FridayUser/inz/README.md

View this project on [CADLAB.io](https://cadlab.io/project/28596). 

# inz
