FridayUser/inz/nowa wersja/Profiler energetyczny urządzeń IoT_V2/Profiler energetyczny urządzeń IoT.kicad_pcb

## KiCad design nowa wersja/Profiler energetyczny urządzeń IoT_V2/Profiler energetyczny urządzeń IoT.kicad_pcb (2024-10-24)

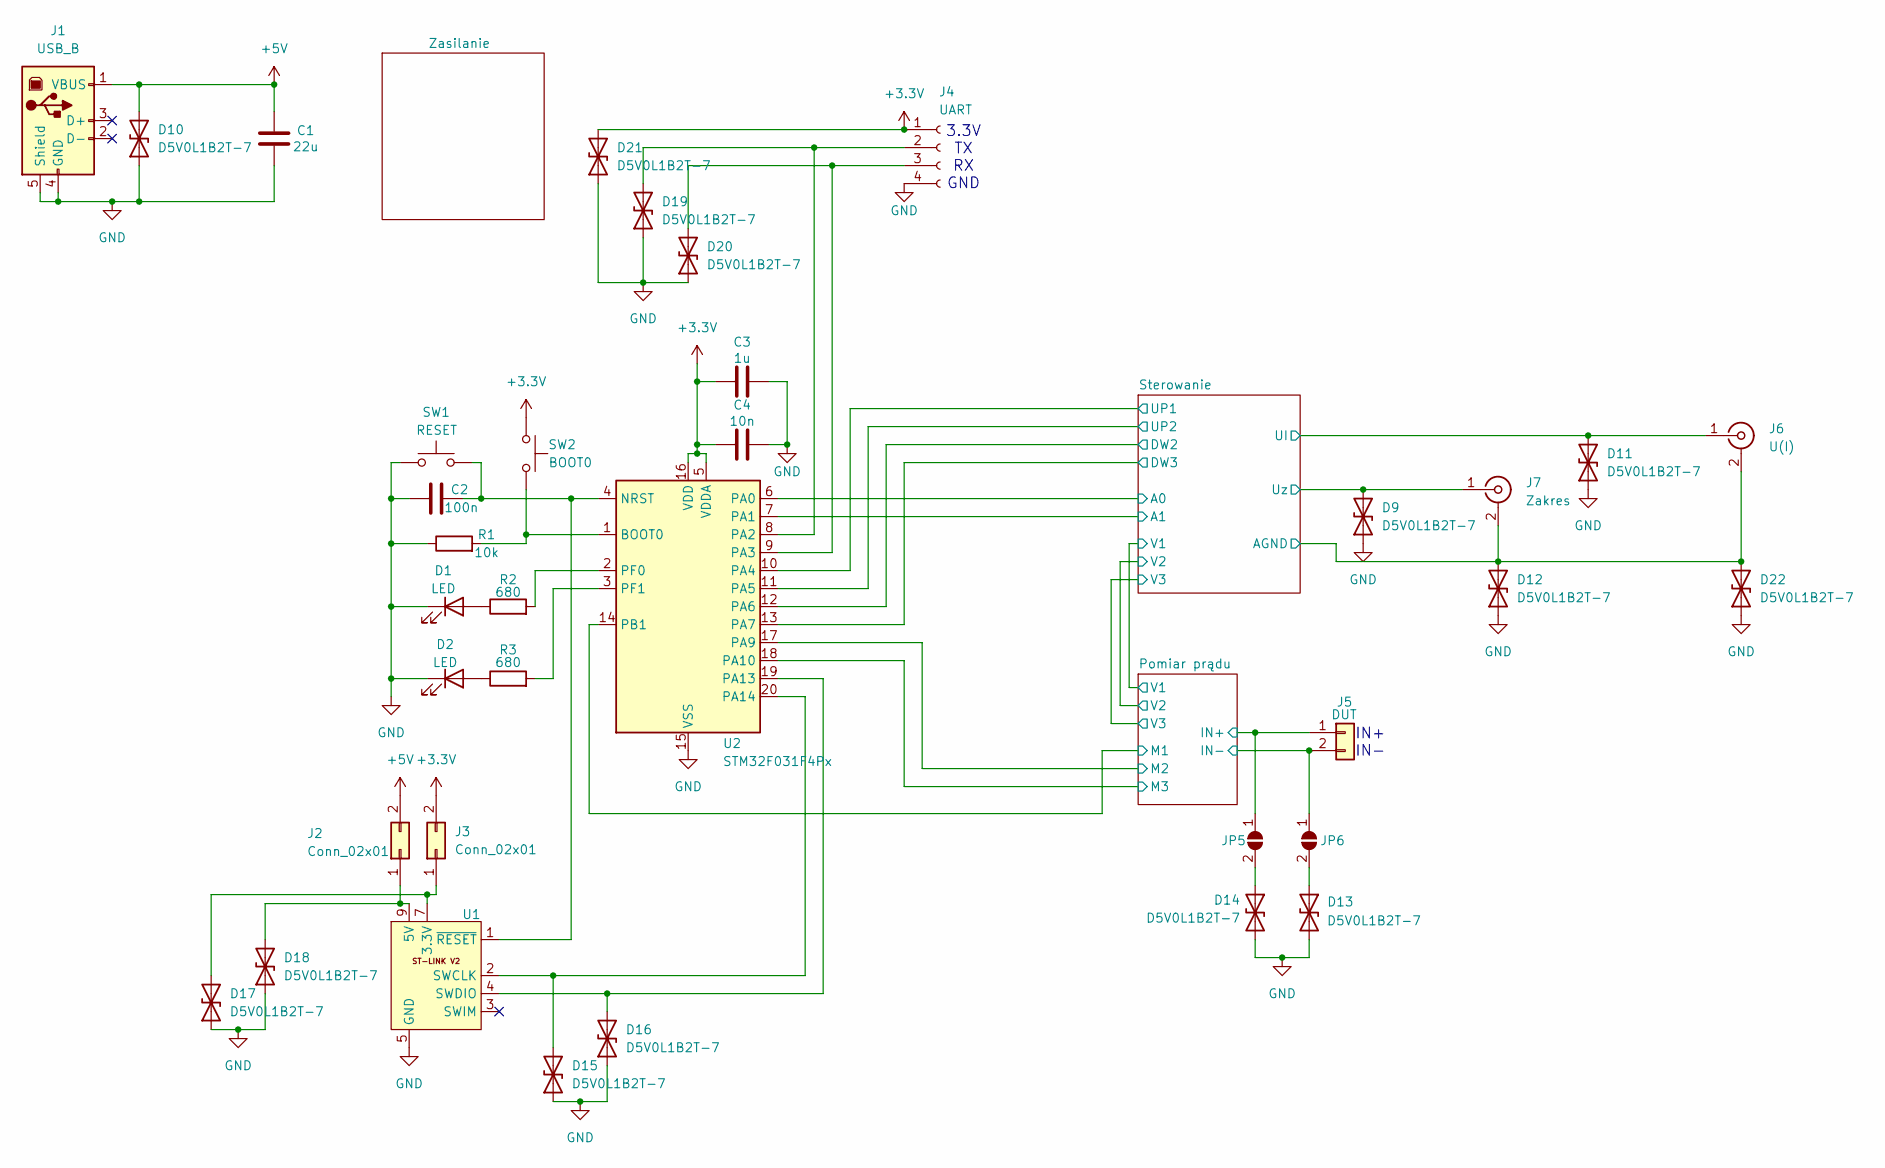
[picture p1: schematic Profiler energetyczny urządzeń IoT.kicad_sch]

Parts:
C1: 22u; C_1206_3216Metric_Pad1.33x1.80mm_HandSolder
C2: 100n; C_0805_2012Metric_Pad1.18x1.45mm_HandSolder
C3: 1u; C_0805_2012Metric_Pad1.18x1.45mm_HandSolder
C4: 10n; C_0805_2012Metric_Pad1.18x1.45mm_HandSolder
D1, D2: LED; LED_miniPLCC_2315_Handsoldering
D9, D10, D11, D12, D13, D14, D15, D16, D17, D18, D19, D20, D21, D22: D5V0L1B2T-7; D_SOD-523
J1: USB_B; USB_B_OST_USB-B1HSxx_Horizontal
J2, J3: Conn_02x01; PinHeader_2x01_P2.54mm_Vertical
J4: UART; PinSocket_1x04_P2.54mm_Vertical
J5: DUT; SolderWire-2sqmm_1x02_P7.8mm_D2mm_OD3.9mm
J6: U(I); BNC_Amphenol_B6252HB-NPP3G-50_Horizontal
J7: Zakres; BNC_Amphenol_B6252HB-NPP3G-50_Horizontal
JP5, JP6: SolderJumper_2_Open; SolderJumper-2_P1.3mm_Open_TrianglePad1.0x1.5mm
R1: 10k; R_0805_2012Metric_Pad1.20x1.40mm_HandSolder
R2, R3: 680; R_0805_2012Metric_Pad1.20x1.40mm_HandSolder
SW1: RESET; SW_SPST_TL3305A
SW2: BOOT0; SW_SPST_TL3305A
U1: IDC-Header_2x05_P2.54mm_Vertical
U2: STM32F031F4Px; TSSOP-20_4.4x6.5mm_P0.65mm

Connections:
3.3V: D17.2 (A2), J3.1, U1.7 (3.3V), U1.8 (3.3V)
5V: D18.2 (A2), J2.1, U1.9 (5V), U1.10 (5V)
+3.3V: C3.1, C4.1, D21.2 (A2), J3.2, J4.1, SW2.1, U2.5 (VDDA), U2.16 (VDD); also elsewhere on the board
+5V: C1.1, D10.2 (A2), J1.1 (VBUS), J2.2; also elsewhere on the board
/M3: U2.18 (PA10)
/Pomiar prądu/IN+: J5.1, JP5.1 (A); also elsewhere on the board
/Pomiar prądu/M1: U2.14 (PB1); also elsewhere on the board
/Pomiar prądu/M2: U2.17 (PA9); also elsewhere on the board
/Sterowanie/A0: U2.6 (PA0); also elsewhere on the board
/Sterowanie/A1: U2.7 (PA1); also elsewhere on the board
/Sterowanie/DW2: U2.12 (PA6); also elsewhere on the board
/Sterowanie/DW3: U2.13 (PA7); also elsewhere on the board
/Sterowanie/UI: D11.2 (A2), J6.1 (In); also elsewhere on the board
/Sterowanie/UP1: U2.10 (PA4); also elsewhere on the board
/Sterowanie/UP2: U2.11 (PA5); also elsewhere on the board
/Sterowanie/Uz: D9.2 (A2), J7.1 (In); also elsewhere on the board
GND: C1.2, C2.1, C3.2, C4.2, D1.1 (K), D2.1 (K), D9.1 (A1), D10.1 (A1), D11.1 (A1), D12.1 (A1), D12.2 (A2), D13.2 (A2), D14.2 (A2), D15.1 (A1), D16.1 (A1), D17.1 (A1), D18.1 (A1), D19.1 (A1), D20.1 (A1), D21.1 (A1), D22.1 (A1), D22.2 (A2), J1.4 (GND), J1.5 (Shield), J4.4, J5.2, J6.2 (Ext), J7.2 (Ext), JP6.1 (A), R1.1, SW1.1, U1.5 (GND), U1.6 (GND), U2.15 (VSS); also elsewhere on the board
unnamed: D1.2 (A), R2.1
unnamed: D2.2 (A), R3.1
unnamed: D13.1 (A1), JP6.2 (B)
unnamed: D14.1 (A1), JP5.2 (B)
unnamed: D15.2 (A2), U1.2 (SWCLK), U2.20 (PA14)
unnamed: D16.2 (A2), U1.4 (SWDIO), U2.19 (PA13)
unnamed: D19.2 (A2), J4.2, U2.8 (PA2)
unnamed: D20.2 (A2), J4.3, U2.9 (PA3)
unnamed: C2.2, SW1.2, U1.1 (~RESET), U2.4 (NRST)
unnamed: R1.2, SW2.2, U2.1 (BOOT0)
unnamed: R2.2, U2.2 (PF0)
unnamed: R3.2, U2.3 (PF1)

Notes on the sheet:
IN+ IN-
3.3V TX RX GND

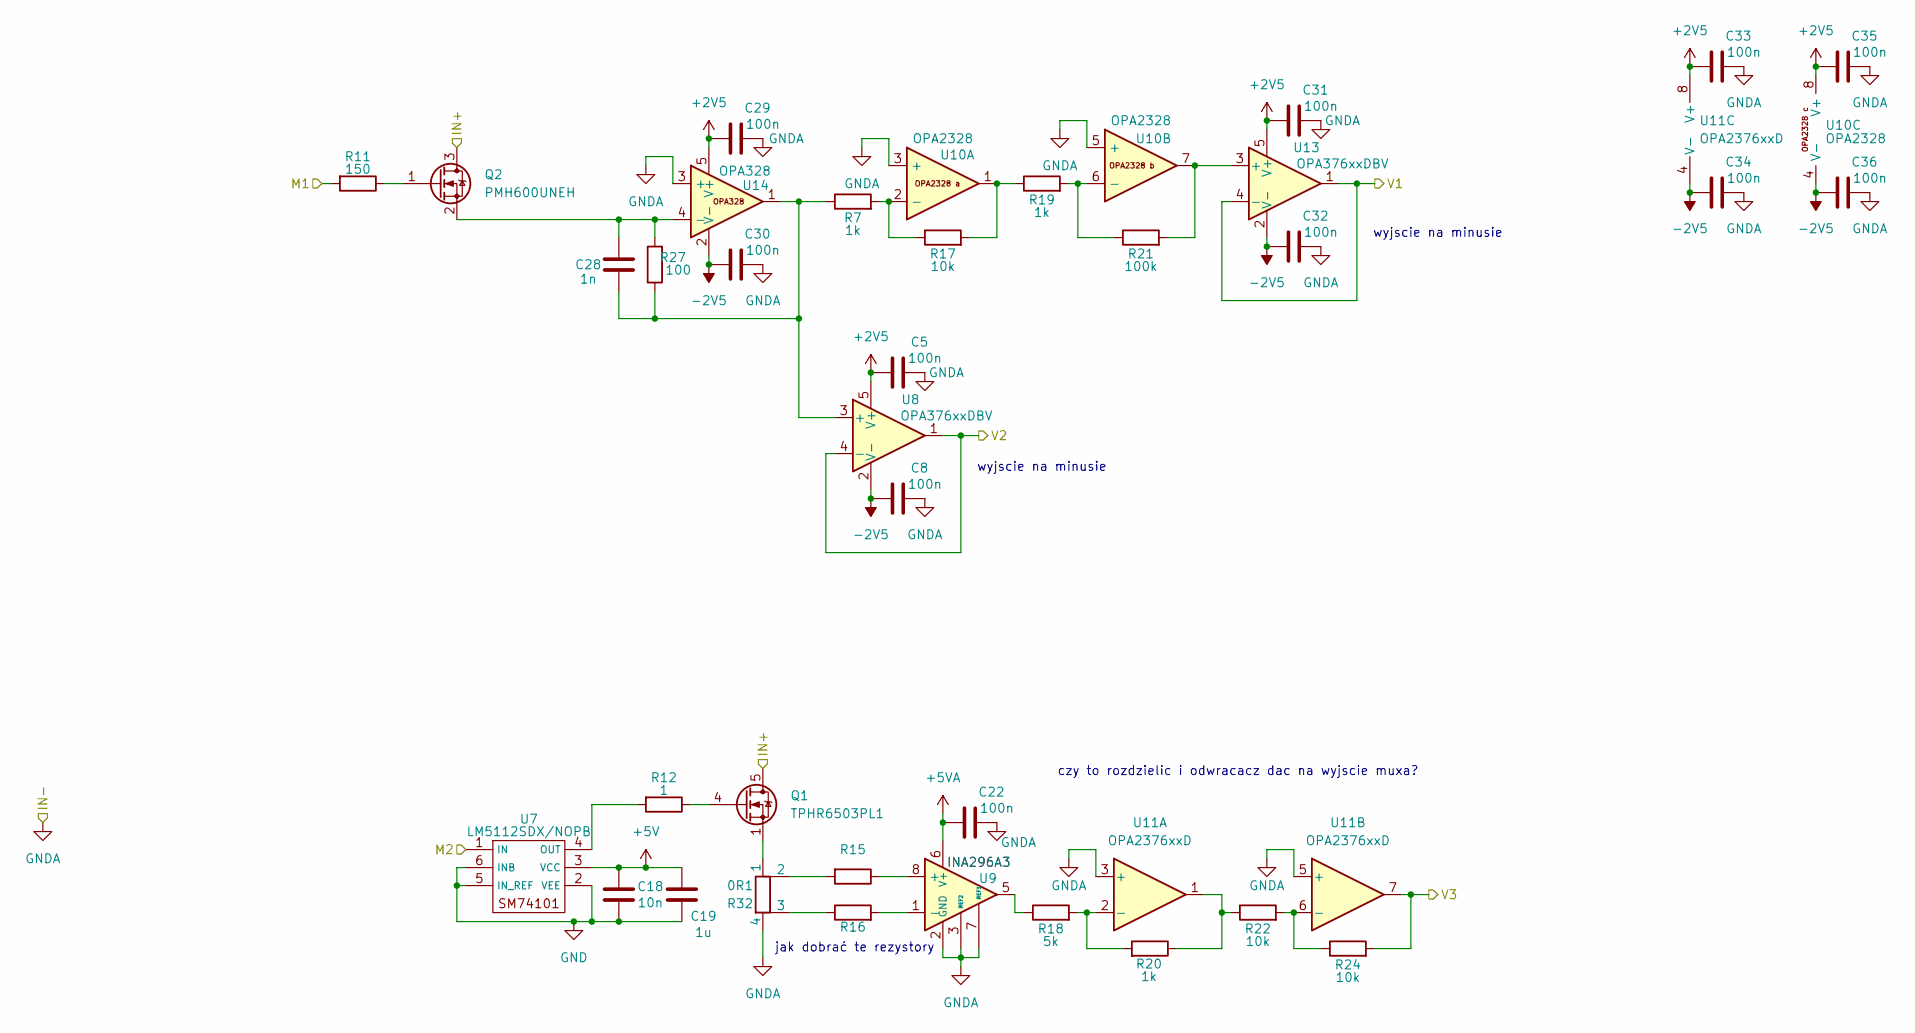
[picture p2: schematic pomiar_pradu.kicad_sch]

Parts:
C5, C8, C22, C29, C30, C31, C32, C33, C34, C35, C36: 100n; C_0805_2012Metric_Pad1.18x1.45mm_HandSolder
C18: 10n; C_0805_2012Metric_Pad1.18x1.45mm_HandSolder
C19: 1u; C_0805_2012Metric_Pad1.18x1.45mm_HandSolder
C28: 1n; C_0805_2012Metric_Pad1.18x1.45mm_HandSolder
Q1: TPHR6503PL1; TDSON-8-1
Q2: PMH600UNEH; DFN606-3
R7, R19, R20: 1k; R_0805_2012Metric_Pad1.20x1.40mm_HandSolder
R11: 150; R_0805_2012Metric_Pad1.20x1.40mm_HandSolder
R12: 1; R_0805_2012Metric_Pad1.20x1.40mm_HandSolder
R15, R16: R_0805_2012Metric_Pad1.20x1.40mm_HandSolder
R17, R22, R24: 10k; R_0805_2012Metric_Pad1.20x1.40mm_HandSolder
R18: 5k; R_0805_2012Metric_Pad1.20x1.40mm_HandSolder
R21: 100k; R_0805_2012Metric_Pad1.20x1.40mm_HandSolder
R27: 100; R_0805_2012Metric_Pad1.20x1.40mm_HandSolder
R32: 0R1; R_Shunt_Ohmite_LVK12
U7: LM5112SDX/NOPB; WSON
U8, U13: OPA376xxDBV; SOT-23-5
U9: INA296A3; SOIC-8_3.9x4.9mm_P1.27mm
U10: OPA2328; VSSOP-8_3.0x3.0mm_P0.65mm
U11: OPA2376xxD; SOIC-8_3.9x4.9mm_P1.27mm
U14: OPA328; SOT-23-5_HandSoldering

Connections:
+2V5: C5.1, C29.1, C31.1, C33.1, C35.1, U8.5 (V+), U10.8 (V+), U11.8 (V+), U13.5 (V+), U14.5 (V+); also elsewhere on the board
+5V: C18.1, C19.1, U7.3 (VCC); also elsewhere on the board
+5VA: C22.1, U9.6 (V+); also elsewhere on the board
-2V5: C8.1, C30.1, C32.1, C34.1, C36.1, U8.2 (V-), U10.4 (V-), U11.4 (V-), U13.2 (V-), U14.2 (V-); also elsewhere on the board
/Pomiar prądu/IN+: Q1.5 (D), Q2.3 (D); also elsewhere on the board
/Pomiar prądu/M1: R11.2; also elsewhere on the board
/Pomiar prądu/M2: U7.1 (IN); also elsewhere on the board
/Pomiar prądu/V1: U13.1, U13.4 (-); also elsewhere on the board
/Pomiar prądu/V2: U8.1, U8.4 (-); also elsewhere on the board
/Pomiar prądu/V3: R24.2, U11.7; also elsewhere on the board
GND: C5.2, C8.2, C18.2, C19.2, C22.2, C29.2, C30.2, C31.2, C32.2, C33.2, C34.2, C35.2, C36.2, R32.4, U7.2 (VEE), U7.5 (IN_REF), U7.6 (INB), U9.2 (GND), U9.3 (REF2), U9.4 (GND), U9.7 (REF1), U10.3 (+), U10.5 (+), U11.3 (+), U11.5 (+), U14.3 (+); also elsewhere on the board
unnamed: Q1.4 (G), R12.1
unnamed: Q1.1 (S), Q1.2 (S), Q1.3 (S), R32.1
unnamed: Q2.1 (G), R11.1
unnamed: C28.2, Q2.2 (S), R27.2, U14.4 (-)
unnamed: R15.2, R32.2
unnamed: R16.1, R32.3
unnamed: R17.2, R19.1, U10.1
unnamed: R18.1, U9.5
unnamed: R20.1, R22.1, U11.1
unnamed: R12.2, U7.4 (OUT)
unnamed: C28.1, R7.1, R27.1, U8.3 (+), U14.1
unnamed: R15.1, U9.8 (+)
unnamed: R16.2, U9.1 (-)
unnamed: R7.2, R17.1, U10.2 (-)
unnamed: R19.2, R21.1, U10.6 (-)
unnamed: R18.2, R20.2, U11.2 (-)
unnamed: R22.2, R24.1, U11.6 (-)
unnamed: R21.2, U10.7, U13.3 (+)

Notes on the sheet:
czy to rozdzielic i odwracacz dac na wyjscie muxa?
jak dobrać te rezystory
wyjscie na minusie

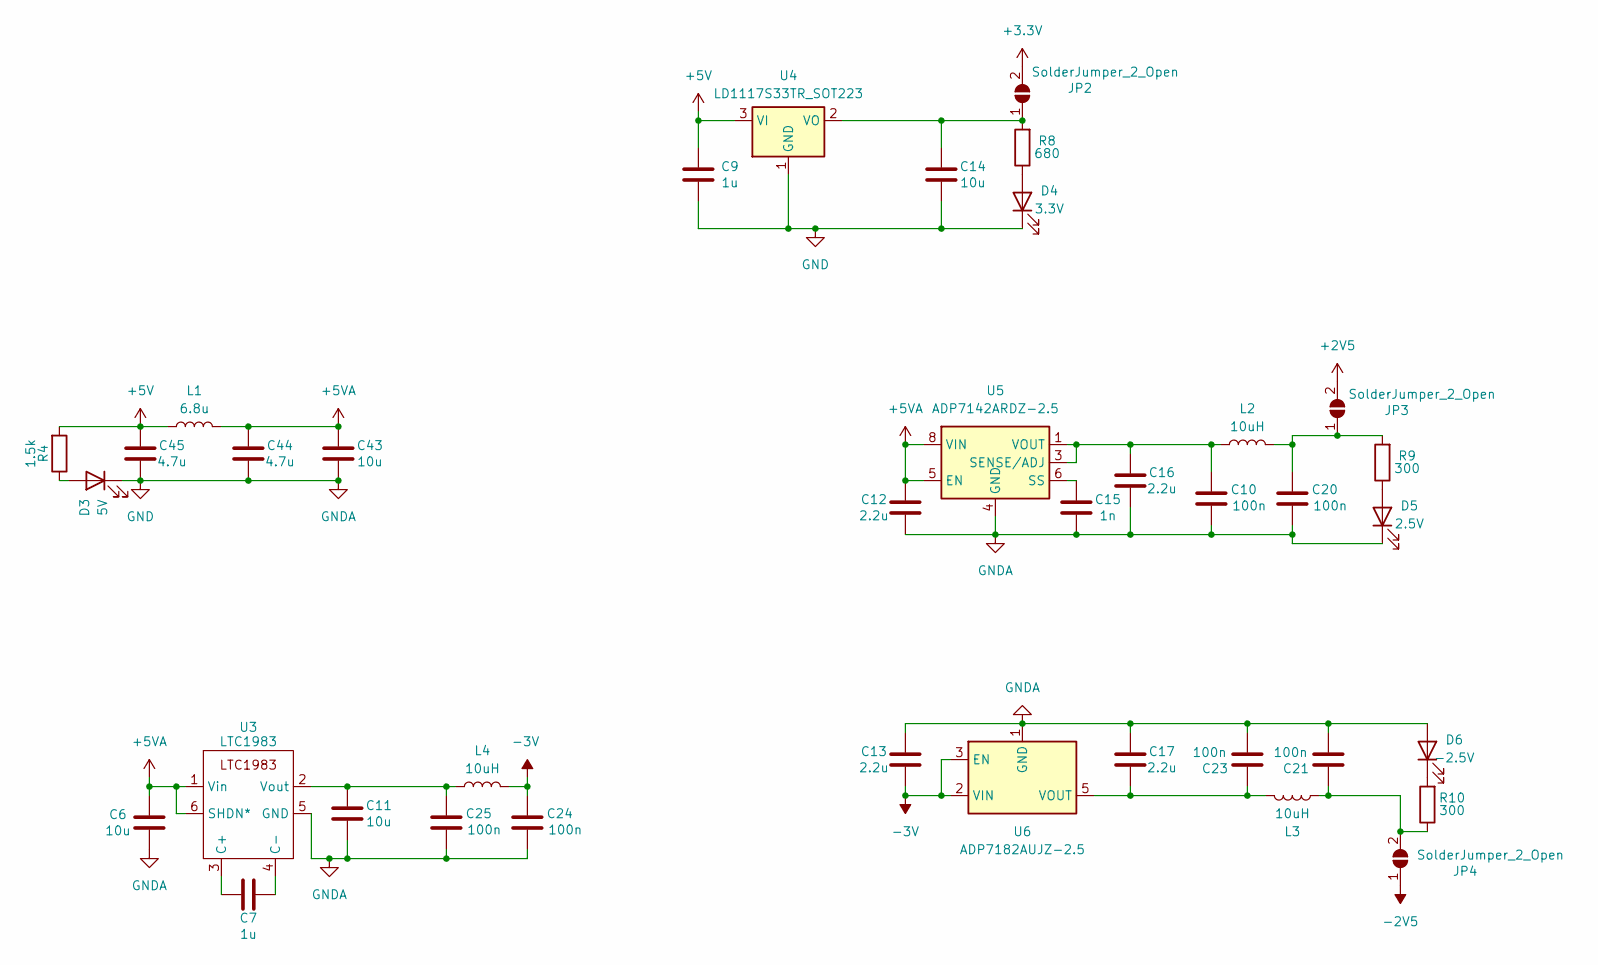
[picture p3: schematic zasilania.kicad_sch]

Parts:
C6, C11, C14, C43: 10u; C_0805_2012Metric_Pad1.18x1.45mm_HandSolder
C7, C9: 1u; C_0805_2012Metric_Pad1.18x1.45mm_HandSolder
C10, C20, C21, C23, C24, C25: 100n; C_0805_2012Metric_Pad1.18x1.45mm_HandSolder
C12, C13, C16, C17: 2.2u; C_0805_2012Metric_Pad1.18x1.45mm_HandSolder
C15: 1n; C_0805_2012Metric_Pad1.18x1.45mm_HandSolder
C44, C45: 4.7u; C_0805_2012Metric_Pad1.18x1.45mm_HandSolder
D3: 5V; LED_miniPLCC_2315_Handsoldering
D4: 3.3V; LED_miniPLCC_2315_Handsoldering
D5: 2.5V; LED_miniPLCC_2315_Handsoldering
D6: -2.5V; LED_miniPLCC_2315_Handsoldering
JP2, JP3, JP4: SolderJumper_2_Open; SolderJumper-2_P1.3mm_Open_TrianglePad1.0x1.5mm
L1: 6.8u; L_Wuerth_WE-PD2-Typ-MS
L2, L3, L4: 10uH; L_1210_3225Metric_Pad1.42x2.65mm_HandSolder
R4: 1.5k; R_0805_2012Metric_Pad1.20x1.40mm_HandSolder
R8: 680; R_0805_2012Metric_Pad1.20x1.40mm_HandSolder
R9, R10: 300; R_0805_2012Metric_Pad1.20x1.40mm_HandSolder
U3: LTC1983; SOT-23-6_Handsoldering
U4: LD1117S33TR_SOT223; SOT-223-3_TabPin2
U5: ADP7142ARDZ-2.5; SOIC-8-1EP_3.9x4.9mm_P1.27mm_EP2.29x3mm
U6: ADP7182AUJZ-2.5; TSOT-23-5

Connections:
+2V5: JP3.2 (B); also elsewhere on the board
+3.3V: JP2.2 (B); also elsewhere on the board
+5V: C9.1, C45.1, L1.1, R4.2, U4.3 (VI); also elsewhere on the board
+5VA: C6.1, C12.1, C43.1, C44.1, L1.2, U3.1 (Vin), U3.6 (SHDN*), U5.5 (EN), U5.7 (VIN), U5.8 (VIN); also elsewhere on the board
-2V5: JP4.1 (A); also elsewhere on the board
-3V: C13.2, C24.2, L4.2, U6.2 (VIN), U6.3 (EN)
GND: C6.2, C9.2, C10.1, C11.2, C12.2, C13.1, C14.2, C15.2, C16.2, C17.1, C20.1, C21.1, C23.1, C24.1, C25.1, C43.2, C44.2, C45.2, D3.1 (K), D4.1 (K), D5.1 (K), D6.2 (A), U3.5 (GND), U4.1 (GND), U5.4 (GND), U5.9 (GND), U6.1 (GND); also elsewhere on the board
unnamed: D3.2 (A), R4.1
unnamed: D4.2 (A), R8.1
unnamed: D5.2 (A), R9.1
unnamed: D6.1 (K), R10.2
unnamed: C14.1, JP2.1 (A), R8.2, U4.2 (VO)
unnamed: C20.2, JP3.1 (A), L2.2, R9.2
unnamed: C21.2, JP4.2 (B), L3.1, R10.1
unnamed: C7.2, U3.3 (C+)
unnamed: C7.1, U3.4 (C-)
unnamed: C11.1, C25.2, L4.1, U3.2 (Vout)
unnamed: C10.2, C16.1, L2.1, U5.1 (VOUT), U5.2 (VOUT), U5.3 (SENSE/ADJ)
unnamed: C15.1, U5.6 (SS)
unnamed: C17.2, C23.2, L3.2, U6.5 (VOUT)

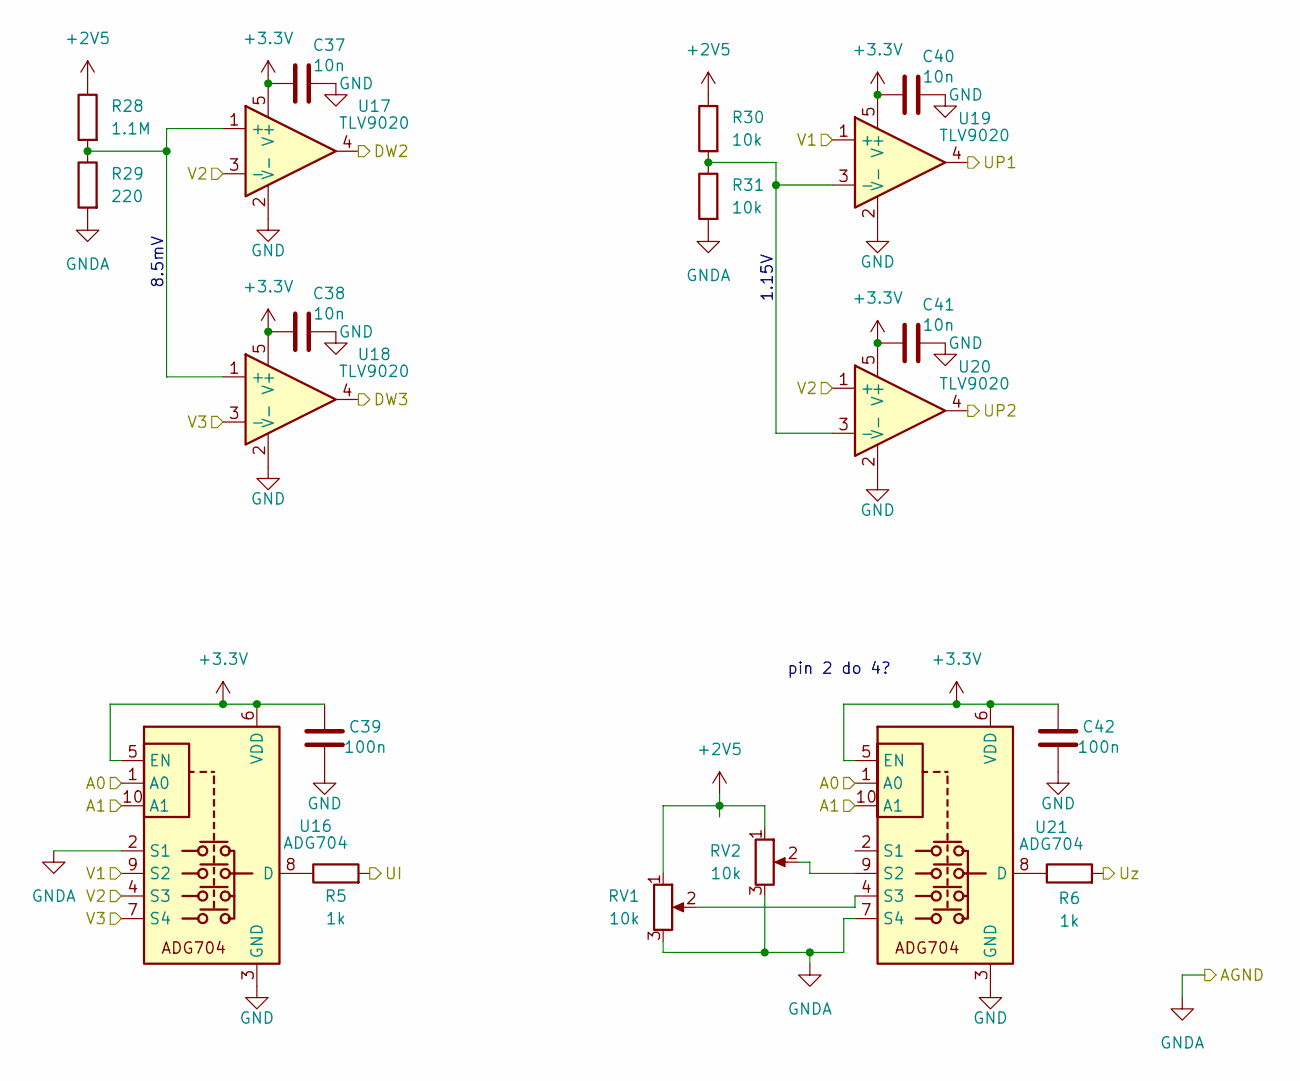
[picture p4: schematic sterowanie.kicad_sch]

Parts:
C37, C38, C40, C41: 10n; C_0805_2012Metric_Pad1.18x1.45mm_HandSolder
C39, C42: 100n; C_0805_2012Metric_Pad1.18x1.45mm_HandSolder
R5, R6: 1k; R_0805_2012Metric_Pad1.20x1.40mm_HandSolder
R28: 1.1M; R_0805_2012Metric_Pad1.20x1.40mm_HandSolder
R29: 220; R_0805_2012Metric_Pad1.20x1.40mm_HandSolder
R30, R31: 10k; R_0805_2012Metric_Pad1.20x1.40mm_HandSolder
RV1, RV2: 10k; Potentiometer_Bourns_3266W_Vertical
U16, U21: ADG704; MSOP-10_3x3mm_P0.5mm
U17, U18, U19, U20: TLV9020; SOT-23-5_HandSoldering

Connections:
+2V5: R28.1, R30.1, RV1.1, RV2.1; also elsewhere on the board
+3.3V: C37.1, C38.1, C39.1, C40.1, C41.1, C42.1, U16.5 (EN), U16.6 (VDD), U17.5 (V+), U18.5 (V+), U19.5 (V+), U20.5 (V+), U21.5 (EN), U21.6 (VDD); also elsewhere on the board
/Pomiar prądu/V1: U16.9 (S2), U19.1 (+); also elsewhere on the board
/Pomiar prądu/V2: U16.4 (S3), U17.3 (-), U20.1 (+); also elsewhere on the board
/Pomiar prądu/V3: U16.7 (S4), U18.3 (-); also elsewhere on the board
/Sterowanie/A0: U16.1 (A0), U21.1 (A0); also elsewhere on the board
/Sterowanie/A1: U16.10 (A1), U21.10 (A1); also elsewhere on the board
/Sterowanie/DW2: U17.4; also elsewhere on the board
/Sterowanie/DW3: U18.4; also elsewhere on the board
/Sterowanie/UI: R5.2; also elsewhere on the board
/Sterowanie/UP1: U19.4; also elsewhere on the board
/Sterowanie/UP2: U20.4; also elsewhere on the board
/Sterowanie/Uz: R6.2; also elsewhere on the board
GND: C37.2, C38.2, C39.2, C40.2, C41.2, C42.2, R29.2, R31.2, RV1.3, RV2.3, U16.2 (S1), U16.3 (GND), U17.2 (V-), U18.2 (V-), U19.2 (V-), U20.2 (V-), U21.3 (GND), U21.7 (S4); also elsewhere on the board
unnamed: R5.1, U16.8 (D)
unnamed: R28.2, R29.1, U17.1 (+), U18.1 (+)
unnamed: R30.2, R31.1, U19.3 (-), U20.3 (-)
unnamed: R6.1, U21.8 (D)
unnamed: RV2.2, U21.9 (S2)
unnamed: RV1.2, U21.4 (S3)

Notes on the sheet:
8.5mV
1.15V
pin 2 do 4?

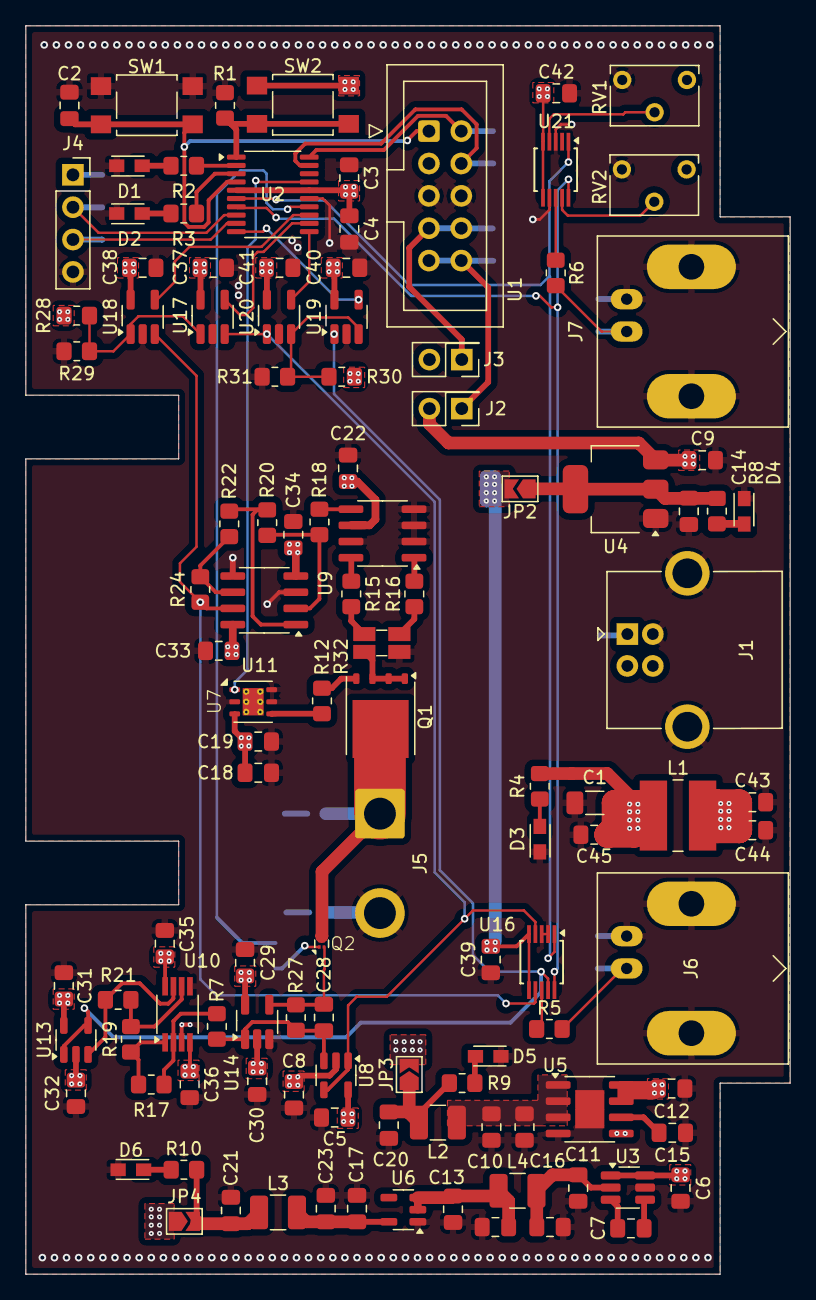
[picture p5: board Profiler energetyczny urządzeń IoT.kicad_pcb from above]

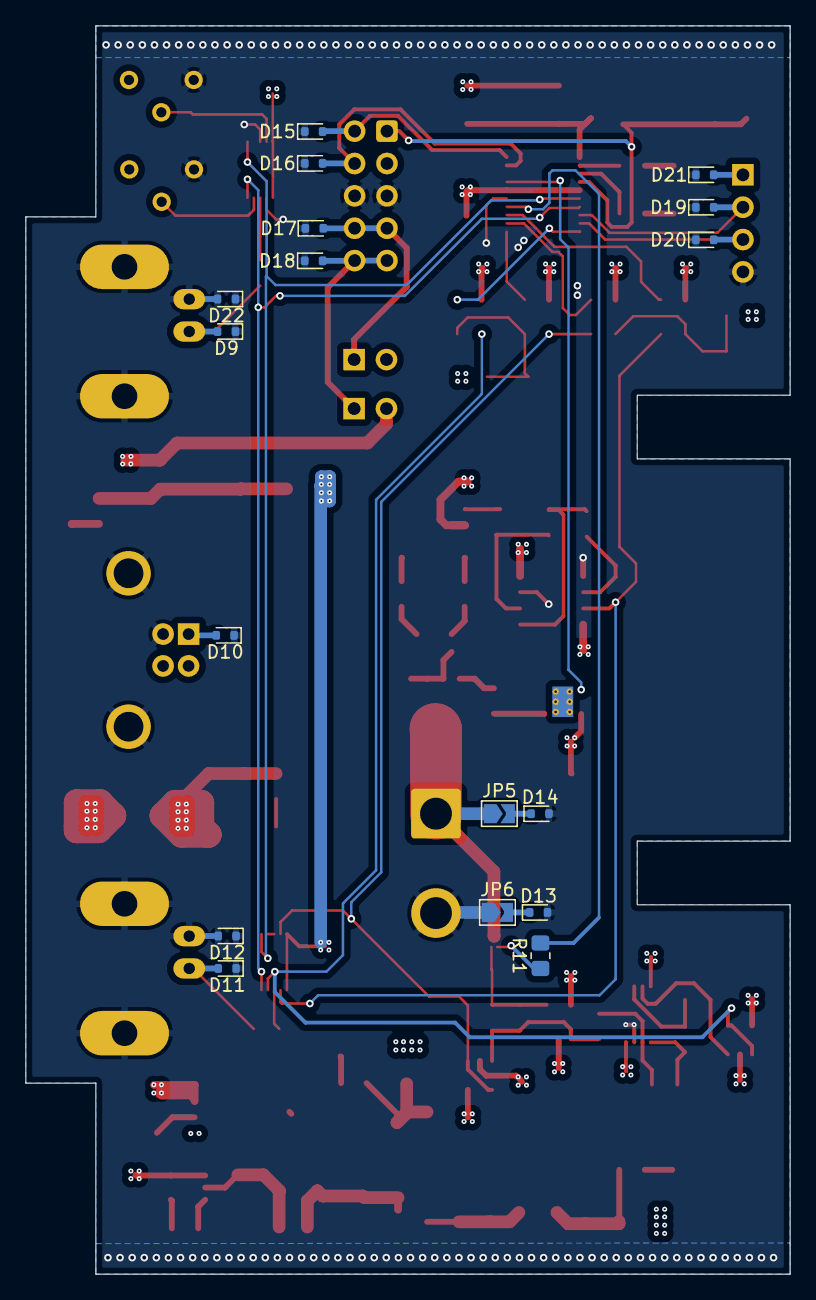
[picture p6: board Profiler energetyczny urządzeń IoT.kicad_pcb from below]

Board: 4 copper layers, 60.0 x 98.0 mm, 131 parts (17 on the bottom side), 72 nets.
